asmnoak/All_in_one_DSP_Radio-RDA5807_and_Internet_Radio-xiao_esp32s3/xiao_esp32_i_d_mini_sch_v2.pdf

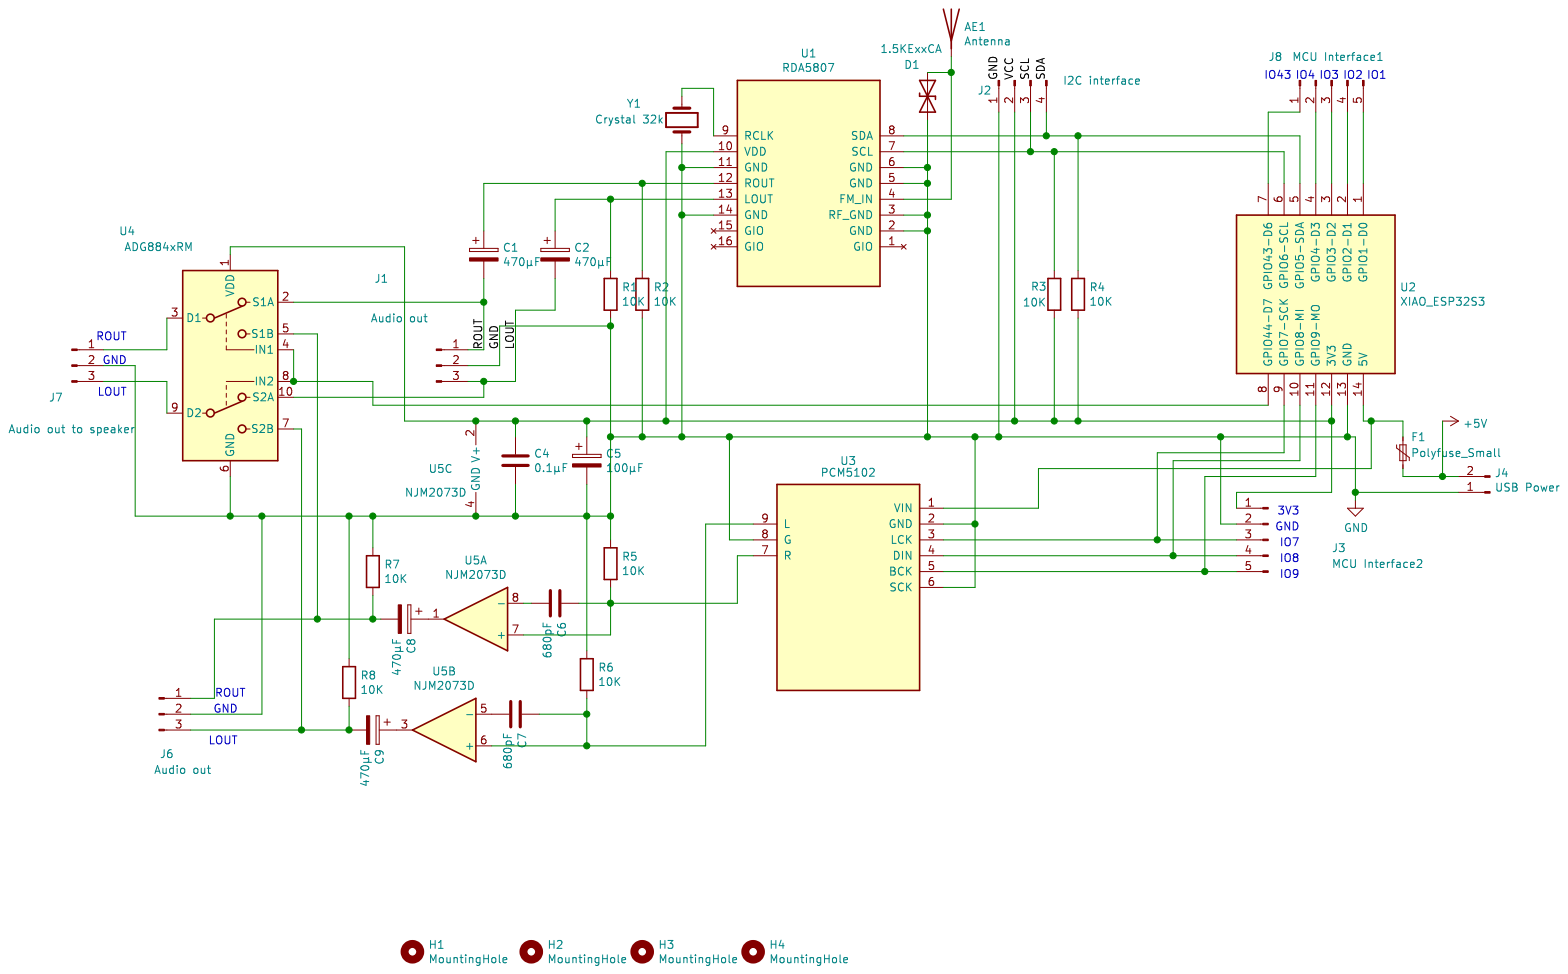
[picture p5: page 1]
