asmnoak/All_in_one_DSP_Radio-RDA5807_and_Internet_Radio-xiao_esp32s3/xiao_esp32s3_ssd1306_i_d_b_radio_master.ino

//**********************************************************************************************************
//*    ESP32S3_inet_and_dsp_radio_srv -- Internet and DSP radio with control function by web server
//*                                      Also you can control ESP32S3 using BLE(Bluetooth LE) GATT without WiFi.
//*
//**********************************************************************************************************
//**********************************************************************************************************
//*    audioI2S -- I2S audiodecoder for ESP32,  refer to https://github.com/schreibfaul1/ESP32-audioI2S                                                            *
//**********************************************************************************************************
//
// Internet radio, first release on 11/2018 for ESP32
//   Version 2  , Aug.05/2019
//   Version 3  , Aug.26/2024 for XIAO ESP32S3
//
// Revise for Internet and DSP : 1/10/2025 - 2/14/2025
// Revise for BLE function     : 3/6/2025 - 4/14/2025
//
#include <BLEDevice.h>
#include <BLEUtils.h>
#include <BLEScan.h>
#include <BLEAdvertisedDevice.h>

#include "Arduino.h"
#include "WiFiMulti.h"
#include "WebServer.h"
#include "Audio.h"
#include <Adafruit_GFX.h>       // install using lib tool
#include <Adafruit_SSD1306.h>   // install using lib tool
#include "Wire.h"
#include <esp_sntp.h>           // esp lib
#include <TimeLib.h>            // https://github.com/PaulStoffregen/Time
#include <Preferences.h>        // For permanent data
#include <RDA5807.h>            // install using lib tool
#define MAXVOL    50          // inet max volume  <= 50
#define MAXVOL_R  15          // radio max volume  <= 15
#define LED_BULTIN       21   // XIAO esp32s3, low level on     
#define I2S_DOUT      8       //## esp32:25  #### old value 2
#define I2S_BCLK      9       //## esp32:26
#define I2S_LRC       7       //## esp32:22
#define SLEEP         43      // sleep timer control button pin #### old value 1 (ver:0.55)
#define PIN_SDA 5             // i2c
#define PIN_SCL 6             // i2c
#define VOL_PIN1     3        // volume up
#define VOL_PIN2     4        // volume down #### old value 44
#define INT_PIN      2        // station change
#define AOUT_SW      44      // audio output switch #### old value 4
#define OLED_I2C_ADDRESS 0x3C // Check the I2C bus of your OLED device
#define SCREEN_WIDTH 128      // OLED display width, in pixels
#define SCREEN_HEIGHT 64      // OLED display height, in pixels
#define OLED_RESET -1         // Reset pin # (or -1 if sharing Arduino reset pin)
#define MAXSTNIDX    7        // station index 0-7          
#define MAXSCEDIDX   8        // schedule table index 0-8
#define VERSION_NR  " ver:0.58"    //
// uuidgen : d392ca55-7a45-47db-adb9-26164b3e7a7b          
static BLEUUID IDBserviceUUID("00001805-7a45-47db-adb9-26164b3e7a7b");
static BLEUUID IDBcharUUID("00002a2b-7a45-47db-adb9-26164b3e7a7b");
static BLEUUID IDBcharDOWUUID("00002a09-7a45-47db-adb9-26164b3e7a7b");
static BLEUUID IDBcharPPCPUUID("00002a04-7a45-47db-adb9-26164b3e7a7b");
#define descriptorUUID "00002901-7a45-47db-adb9-26164b3e7a7b"
#define LOCAL_NAME "DSP_INET_radio"
BLEServer  *pServer = NULL;
BLEClient  *pClient = NULL;
BLEAddress *pBLEAddress = NULL;
BLEDescriptor *pDescriptor = new BLEDescriptor("00002901-7a45-47db-adb9-26164b3e7a7b");  
static bool connected = false;  // ble connection is active 
static bool advertise = false;  // ble advertise is active 
static bool wrote = false;      // ble onwrite() of decriptorcallback
static char strbuff[24];
static const char *stnStr[7] = {"ST0","ST1","ST2","ST3","ST4","ST5","ST6"}; // 3 char, preferences:key of radio station name 
int max_radio = 7;  // max radio station
int bdow = 0; // current browser day of week
int bstn = 0; // current browser radio station
String wstr = "";
//
//
Audio audio;
WiFiMulti wifiMulti;
Adafruit_SSD1306 oled(SCREEN_WIDTH, SCREEN_HEIGHT, &Wire, OLED_RESET);
RDA5807 radio;
// WiFi
String ssid =     "SSID1";         // WiFi 1, specify your access point
String password = "PASSWORD1";
String ssid2 =     "SSID2";      // WiFi 2, uncomment wifiMulti.addAP() below
String password2 = "PASSWORD2";          // if you want to specify it
// time
struct tm *tm;
int d_mon ;
int d_mday ;
int d_hour ;
int d_min = 99;
int d_sec ;
int d_wday ;
int last_d_sec = 99;
int last_d_min = 99;
static const char *weekStr[7] = {"Sun","Mon","Tue","Wed","Thu","Fri","Sat"}; // 3 char, preferences:key of week schedule
int currIdx = 99;
int pofftm_h = 0;
int pofftm_m = 0;
const char* ntpServer = "ntp.nict.jp";
const long  gmtOffset_sec = 32400;
const int   daylightOffset_sec = 0;
// mode: inet or dsp
bool mode_chg_ok = true;
bool mode_chg_req = false;
//
int volume = 2; // inet volume
int station = 0; // inet station url
int ct2,pt2,event;  // interval time 
bool sleepmode = false;
int s_remin = 99;
// mode
int inet_radio = 0;  //0: DSP radio, 1: Internet radio on
bool led_onoff = true;
int loop_cnt = 0;

// Preset internet station url and name
const char* station_url[]={
  "http://cast1.torontocast.com:2170/stream",  "http://cast1.torontocast.com:2120/stream",
  "http://jenny.torontocast.com:8062/stream",  "http://51.195.203.179:8002/stream",
  "http://216.235.89.171:80/hitlist",  "string 6"
};
const char* station_name[]={
  "JPopSakura",  "JPop hits",
  "J1GOLD",  "HotHits UK",
  "POWERHIT40",  "string 6"
}; // max 10 char
char stnurl[128];  // current internet station url
char stnname[24];  // current internet station name
int max_station = 5; // valid entry
// web server
WebServer server(80);  // port 80(default)
// Operation by server
int stoken = 0;  // server token, count up 
int s_srv = 1; // server request 
int s = 1; // toggle sleep
int a_srv = 1;
int b_srv = 1;
char titlebuf[166];
char rstr[128];
// DSP Radio RDA5807
int  vol_r;
//int  lastvol;
int  stnIdx;
int  laststnIdx;
int  stnFreq[] = {8040, 8250, 8520, 9040, 9150, 7620, 7810, 7860}; // frequency of radio station
String  stnName[] = {"AirG", "NW", "NHK", "STV", "HBC", "sanka", "karos", "nosut"}; // name of radio station max 5 char
std::string stnList = "";

String msg = "none";
bool bassOnOff = false;
bool vol_ok = true;
bool stn_ok = true;
bool p_onoff_req = false;
bool p_on = false;
uint32_t currentFrequency;
float lastfreq;
struct elm {  // program
   int stime; // strat time(min)
   int fidx;  // frequency table index
   int duration; // length min
   int volstep; // volume
   int poweroff; // if 1, power off after duration
   int scheduled; // if 1, schedule done for logic
};
struct elm entity[7][MAXSCEDIDX + 1] = {
{{390,1,59,2,1,0},{540,6,59,1,0,0},{600,0,59,1,0,0},{660,3,119,1,0,0},{780,1,59,1,0,0},{840,0,59,1,0,0},{900,6,59,1,0,0},{1140,3,119,1,0,0},{1410,0,29,1,1,0}}, // sun
{{390,4,59,2,1,0},{480,3,119,1,0,0},{600,6,59,1,0,0},{720,2,119,1,0,0},{840,1,119,1,0,0},{0,0,0,0,0,0},{1020,1,119,1,0,0},{1200,6,89,1,0,0},{1410,0,29,1,1,0}}, // mon
{{390,4,59,2,1,0},{480,3,119,1,0,0},{720,2,89,1,0,0},{840,1,119,1,0,0},{0,0,0,0,0,0},{0,0,0,0,0,0},{1020,1,119,1,0,0},{1200,0,89,1,0,0},{1410,0,29,1,1,0}}, // tue
{{390,4,59,2,1,0},{480,3,119,1,0,0},{720,2,89,1,0,0},{840,1,119,1,0,0},{0,0,0,0,0,0},{0,0,0,0,0,0},{1020,1,119,1,0,0},{1200,0,89,1,0,0},{1410,0,29,1,1,0}}, // wed
{{390,4,59,2,1,0},{480,3,119,1,0,0},{600,6,59,1,0,0},{720,2,119,4,0,0},{840,1,119,1,0,0},{960,1,59,1,0,0},{1080,1,119,1,0,0},{1200,0,89,1,0,0},{1290,3,59,1,1,0}}, // thu
{{390,4,59,2,1,0},{480,3,119,1,0,0},{660,0,59,1,0,0},{720,2,119,1,0,0},{840,6,119,1,0,0},{0,0,0,0,0,0},{1080,1,119,1,0,0},{1200,1,89,1,0,0},{1290,3,59,1,1,1}}, // fri
{{390,0,29,2,0,0},{420,2,119,1,0,0},{540,2,110,1,0,0},{720,2,119,1,0,0},{840,2,119,1,0,0},{960,2,119,1,0,0},{1080,4,59,1,0,0},{1140,3,119,1,0,0},{1260,0,89,1,1,0}}  // sat
};
Preferences preferences; // Permanent data "WF0":WiFi SSID, "vol":inet volume, "volr":dsp vol_r , "stix":dsp stnIdx, "stn":inet station
//
//
int setWeeksced(String wstr);
int setStation(String wstr);

class MyDescriptorCallbacks: public BLEDescriptorCallbacks {
  void onWrite(BLEDescriptor *pDesciptor) {
    uint8_t *value = pDescriptor->getValue();
    int vl = pDescriptor->getLength();
    int i;
    wrote = true;
    if (vl >= sizeof(strbuff)) vl = 22;
    Serial.print("***** New value: ");
    memcpy(strbuff, value, vl);
    strbuff[vl] = '\n';
    strbuff[vl+1] = 0;
    if (strbuff[0]=='W') { // Day of Week selection
       bdow = strbuff[2] - '1';
       if (bdow < 0 || bdow >= 7) {
         Serial.println("Description err data");
         bdow=0;
        }
    }
    else if (strbuff[0]=='S') { // Radio Staion selection
       bstn = strbuff[2] - '0';
       if (bstn < 0 || bstn >= MAXSTNIDX) {
         Serial.println("Description err data");
         bstn=0;
        }
    }
    Serial.println(strbuff);
  }
};

class MyCallbacks: public BLECharacteristicCallbacks {
  int typ;
  public:
   MyCallbacks(int t){ typ = t;};
  void onWrite(BLECharacteristic *pCharacteristic) {
    Serial.println("MyCallbacks Write");
    wstr = "";
    msg = "";
    std::string value = pCharacteristic->getValue();
    if (value.length() > 0) {
      Serial.print("***** New value: ");
      for (int i = 0; i < value.length(); i++) {
        Serial.print(value[i]);
        wstr += value[i];
      }
      Serial.println();
      int rc = 0;
      if (value.length() < 40) {
        rc = setStation(wstr);   // register new station
        //if (rc != 0) Serial.println(msg);
      } else {
        rc = setWeeksced(wstr);  // register new schedule
        //if (rc != 0) Serial.println(msg);
      }
      Serial.println(msg);
    }
  }
  void onRead(BLECharacteristic *pCharacteristic) {
    std::string wsced ="";
    char htstr[180];
    Serial.println("MyCallbacks Read");
    if (typ == 0)  return; // nop if not necessary
    int i=bdow;
      wsced = weekStr[bdow];
      wsced += ";";
      for(int j = 0; j <= MAXSCEDIDX; j++) {
        sprintf(htstr,"%d:%02d,%d,%d,%d,%d",entity[i][j].stime / 60,entity[i][j].stime % 60,entity[i][j].fidx,entity[i][j].duration,entity[i][j].volstep,entity[i][j].poweroff);
        wsced += htstr;
        if (j != MAXSCEDIDX) wsced += ";";
      }
      wsced += ";";
    wsced += "\n\0";
    pCharacteristic->setValue(wsced);
  }
};
class MyCallbacks2: public BLECharacteristicCallbacks {
  void onWrite(BLECharacteristic *pCharacteristic) {
    Serial.println("MyCallbacks2 Write");
    wstr = "";
    msg = "";
    std::string value = pCharacteristic->getValue();
    if (value.length() > 0) {
      Serial.print("***** New value: ");
      for (int i = 0; i < value.length(); i++) {
        Serial.print(value[i]);
        wstr += value[i];
      }
      Serial.println();
      if (value.length() < 40) {
        setStation(wstr);   // registor new station
      } else {
        setWeeksced(wstr);  // register new schedule
      }
      Serial.println(msg);
    }
  }
  void onRead(BLECharacteristic *pCharacteristic) {
    std::string stn ="";
    char htstr[80];
    float tf;
    Serial.println("MyCallbacks2 Read");
    int i=bstn;
      stn = stnStr[bstn];
      stn += ",";
      tf = stnFreq[bstn]/100.0;
      sprintf(htstr,"%3.1f",tf);
      stn += htstr;
      stn += ",";
      stn += stnName[bstn].c_str();
    stn += "\n\0";
    pCharacteristic->setValue(stn);
  }
};

class MyServerCallbacks: public BLEServerCallbacks {
  void onConnect(BLEServer* pServer, esp_ble_gatts_cb_param_t *param) {
    pBLEAddress = new BLEAddress(param->connect.remote_bda);
    Serial.printf("MyServerCallbacks Server Connected: %s\n", pBLEAddress->toString().c_str());
    connected = true;
    advertise = false;
    pServer->getAdvertising()->stop();  // stop Advertise
    Serial.println("MyServerCallbacks Stop Advertising");
  }

  void onDisconnect(BLEServer* pServer) {
    Serial.println("MyServerCallbacks Server Disconnected");
    connected = false;
  }
};
int setStation(String val1){
  String instr[12] = {"\n"};
  int ix = split(val1,',',instr);
  if (ix != 3) {
    msg = "different number of arguments.";
    return 4;
  } else {
    //msg = "arguments. ok.";
    instr[0].trim();
    String str = instr[0].substring(2,3);
    int stn = str.toInt();
    char tstr[80];
    sprintf(tstr,"%s:%s==%d", instr[0], str, stn);
    Serial.println(tstr);
    if (stn > MAXSTNIDX-1) { msg = "invalid number of stations."; return 4;}
    else {
      // normal process
      msg = "OK! Processing.";
      if (instr[0].substring(0,1).equals("W")) {// wifi setup
         preferences.putString("WF0", val1);
         Serial.println("Regiter WiFi info: " + val1);
      } else {
        instr[1].trim();
        float freq = instr[1].toFloat();
        if (freq < 50 || freq > 108) {
          msg = "invalid frequency.";
          return 4;
        }
        stnFreq[stn] = freq * 100;
        instr[2].trim();
        stnName[stn] = instr[2];
        preferences.putString(stnStr[stn], val1);  // save permanently
        Serial.println("Regiter new station: " + val1);
      }
      msg = "OK! Done.";
      return 0;
    }
  } 

}


int split(String data, char delimiter, String *dst){
  int index = 0;
  int arraySize = (sizeof(data))/sizeof((data[0]));
  int datalength = data.length();
  
  for(int i = 0; i < datalength; i++){
    char tmp = data.charAt(i);
    if( tmp == delimiter ){
      index++;
      if( index > (arraySize - 1)) return -1;
    }
    else dst[index] += tmp;
  }
  return (index + 1);
}
int dayofWeek(String dow) {
  dow.trim();
  //Serial.println(dow);
  if (dow.equals("Sun")) return 0; 
  else if (dow.equals("Mon")) return 1;
  else if (dow.equals("Tue")) return 2;
  else if (dow.equals("Wed")) return 3;
  else if (dow.equals("Thu")) return 4;
  else if (dow.equals("Fri")) return 5;
  else if (dow.equals("Sat")) return 6;
  else return 9;
}

//Preferences preferences; // Permanent data

int setWeeksced(String val1){
  String instr[12] = {"\n"};
  String instr2[8] = {"\n"};
  String instr3[4] = {"\n"};
  int ix = split(val1,';',instr);
  if (ix != 11) {
    msg = "different number of arguments.";
    return 4;
  } else {
    //msg = "arguments. ok.";
    int down = dayofWeek(instr[0]);
    if (down > 6) { msg = "invalid day of week."; return 4;}
    else {
      // normal process
      msg = "normal process.";
      instr[0].trim();
      Serial.println(instr[0]);
      for(int j = 0; j <= MAXSCEDIDX; j++) {
        instr[j+1].trim();
        msg = "normal process 2.";
        //Serial.println(instr[j+1]);
        String val2 = instr[j+1];
        ix = split(val2,',',instr2);
        if (ix != 5) { 
            msg = "different number of  2nd level arguments.";
            return 4;
        } else {
            //for(int i = 0; i < 5; i++) {
              msg = "OK! Processing.";
              //Serial.println(instr2[i]);
              val2 = instr2[0];
              ix = split(val2,':',instr3);
              if (ix != 2) {
                msg = "different number of  3rd level arguments.";
                return 4;
              }
              instr3[0].trim();
              instr3[1].trim();
              entity[down][j].stime = instr3[0].toInt() * 60 + instr3[1].toInt();
              instr3[0] = "";
              instr3[1] = "";
              instr2[0] = "";

              entity[down][j].fidx = instr2[1].toInt();
              // todo: check fidx
              instr2[1] = "";
              entity[down][j].duration = instr2[2].toInt();
              instr2[2] = "";
              entity[down][j].volstep = instr2[3].toInt();
              instr2[3] = "";
              entity[down][j].poweroff = instr2[4].toInt();
              instr2[4] = "";
              entity[down][j].scheduled = 0; // reset
              preferences.putString(weekStr[down], val1);  // save permanently
            //}
        }
        
      }
      if (d_wday==down) { //  Is schedule of today changed?  (ver:0.52)
        pofftm_h = 0;     // clear power off time
        pofftm_m = 0;
        Serial.println("reset power off time");
      }
      msg = "OK! Done.";
      return 0;
    }
  } 
}
void handleRoot(void)
{
  String html;
  String val1;
  String val2;
  String val3;
  String val4;
  String val5;
  String val6;
  String val7;
  String val8;
  String val9;
  String val10;
  String val11;
  String html_btn0 = "<p><div class=\"lay_i\"><input type=\"submit\" name=\"dsp\"  value=\"dsp_radio\" class=\"btn_g\"><input type=\"submit\" name=\"inet\" value=\"inet_radio\" class=\"btn\"></div></p>";
  String html_btn1 = "<p><div class=\"lay_i\"><input type=\"submit\" name=\"dsp\"  value=\"dsp_radio\" class=\"btn\"><input type=\"submit\" name=\"inet\" value=\"inet_radio\" class=\"btn_g\"></div></p>";
  String html_p1; 
  char htstr[180];
  char stnno[4];    
  char tno[4];
  char stnmsg[12];
  bool responsed = false;
  stnmsg[0]=0;

  Serial.println("web received");
  if (inet_radio == 0) html_p1 = html_btn0; else html_p1 = html_btn1;
  if (server.method() == HTTP_POST) { // submitted with string
    val1 = server.arg("daysced");
    val2 = server.arg("vup");
    val3 = server.arg("vdown");
    val4 = server.arg("stnup");
    val5 = server.arg("stndown");
    val6 = server.arg("sleep");
    val7 = server.arg("stoken");
    val8 = server.arg("stnset");
    val9 = server.arg("pwonoff");
    val10 = server.arg("dsp");
    val11 = server.arg("inet");
    if (val7.length() != 0) { // server token
      Serial.print("stoken:");
      String s_stoken = server.arg("stoken");
      int t_stoken = s_stoken.toInt();
      Serial.println(s_stoken);
      msg = "stoken:" + s_stoken;
      if (stoken > t_stoken) {
        Serial.println("redirect");
        msg = "Post converted to Get";
        responsed = true;
        server.send(307, "text/html", "<!DOCTYPE html><html><head><meta charset=\"utf-8\"><meta http-equiv=\"refresh\" content=\"0;url=/\"></head></html>");
      }
    }
    if (!responsed){
      ////
      if (val10.length() != 0) {
        Serial.println("dsp");
        if (mode_chg_ok && (inet_radio == 1)) {
          // inet --> dsp
          html_p1 = html_btn0;
          mode_chg_ok = false;
          mode_chg_req = true;
        }
        msg = "dsp";
      }
      else if (val11.length() != 0) {
        Serial.println("inet");
        if (mode_chg_ok && (inet_radio == 0)) {
          // dsp --> inet
          html_p1 = html_btn1;
          mode_chg_ok = false;
          mode_chg_req = true;
        }
        /*WiFiClient client = server.client(); 
        client.println("HTTP/1.1 307 Temporary Redirect");
        client.println("Location: /ir");
        client.println("Connection: Close");
        client.print("<HEAD>");
        client.print("<meta http-equiv=\"refresh\" content=\"0;url=/ir\">");
        client.print("</head>");
        client.println();
        client.stop();*/
        msg = "inet";
      } else if (val8.length() != 0) {
        Serial.println("station set");
        if (val8 == "set") {
          Serial.print("Set_staion: ");
          // Get input station setting
          String s_stnurl = server.arg("stnurl");
          String s_stnname = server.arg("stnname");
          String s_stnno = server.arg("stnno");
          Serial.print(s_stnno); Serial.print(" "); Serial.print(s_stnname); Serial.print(" ");
          Serial.println(s_stnurl);
          // Set current
          strcpy(stnurl,s_stnurl.c_str());
          strcpy(stnname,s_stnname.c_str());
          station = s_stnno.toInt() - 1;
          if (station < max_station && station >= 0) {
            bool conn_ok;
            conn_ok=audio.connecttohost(s_stnurl.c_str()); // change station
            if (conn_ok) {
                Serial.println("Set new staion OK");
                msg = "Set new staion OK";
            } else {
                Serial.println("Set new staion failed");
                strcpy(stnmsg,"Err!");
                msg = "Set new staion error";
            }
          } else msg = "illegal station number";
        } else if (val8 == "save") {
          String s_stnurl = server.arg("stnurl");
          String s_stnname = server.arg("stnname");
          String s_stnno = server.arg("stnno");
          int stnno = s_stnno.toInt();
          Serial.print(s_stnno); Serial.print(" "); Serial.print(s_stnname); Serial.print(" ");
          Serial.println(s_stnurl);
          if (stnno - 1 <= max_station && stnno -1 >= 0) {
            char tstr[166];
            sprintf(tstr,"%s%d","st", stnno);
            preferences.putString(tstr,s_stnurl);
            sprintf(tstr,"%s%d","nm", stnno);
            preferences.putString(tstr,s_stnname);
            msg = "new station saved";
          } else msg = "illegal station number";
        }
        else msg = "ignore it";
      }
      else if (val2.length() != 0) {
        Serial.println("vup");
        b_srv=0; 
        msg = "control vup";
      }
      else if (val3.length() != 0) {
        Serial.println("vdown");
        a_srv=0; 
        msg = "control vdown";
      }
      else if (val4.length() != 0) {
        Serial.println("stnup");
        station_setting();
        msg = "control stnup";
      }
      else if (val5.length() != 0) {
        Serial.println("stndown");
        station_setting();
        msg = "control stndown";
      }
      else if (val6.length() != 0) {
        Serial.println("sleep");
        sleep_setting();
        msg = "control sleep";
      }
      else if (val9.length() != 0) {
        Serial.println("pwonoff");
        if (inet_radio==0 || inet_radio==1) { // dsp radio, or inet (changed)
          power_onoff_setting(); 
          msg = "control pwonoff";
        } else msg = "ignore it";
      }
      else if (val1.length() != 0) {
        Serial.println("daysched");
        if (inet_radio>=0) { // dsp radio or inet radio
          int rc = setWeeksced(val1); 
          //msg = "control daysched";
        } else msg = "ignore it";
      }
      else {
        // nop        
      } 
    }
  } 
  if (!responsed) {
    html = "<!DOCTYPE html><html><head><meta charset=\"utf-8\"><title>DSP Inet Radio</title>";
    html +="</head><body><form action=\"\" method=\"post\">";
    html += "<p><h2>DSP Radio & Internet Radio</h2></p>";
    html += html_p1;
    html += "<style>.lay_i input:first-of-type{margin-right: 20px;}</style>";
    html += "<style>.btn {width: 300px; padding: 10px; box-sizing: border-box; border: 1px solid #68779a; background: #cbe8fa; cursor: pointer;}</style>";
    html += "<style>.btn_y {width: 300px; padding: 10px; box-sizing: border-box; border: 1px solid #68779a; background: #ffff8a; cursor: pointer;}</style>";
    html += "<style>.btn_g {width: 300px; padding: 10px; box-sizing: border-box; border: 1px solid #68779a; background: #99ff99; cursor: pointer;}</style>";
    //html += "<script>function stokenupd() {const hdtoken = document.getElementById('stoken'); hdtoken.value += 1;}</script>";
    html += "<p>Control Functions</p>";
    html += "<p><div class=\"lay_i\"><input type=\"submit\" name=\"vup\"  value=\"volume up\" class=\"btn\"><input type=\"submit\" name=\"vdown\" value=\"volume down\" class=\"btn\"></div></p>";
    html += "<p><div class=\"lay_i\"><input type=\"submit\" name=\"stnup\"  value=\"station change\" class=\"btn\"></div></p>";
    html += "<p><div class=\"lay_i\"><input type=\"submit\" name=\"pwonoff\"  value=\"dsp_radio pwr_on_off\" class=\"btn_y\">";
    html += "<input type=\"submit\" name=\"sleep\"  value=\"inet_radio sleep\" class=\"btn_y\"></div></p>";
    html += "<p>Volume: ";
    if (inet_radio==1) sprintf(tno,"%d",volume); else sprintf(tno,"%d",vol_r);
    html += tno;
    html += "</p>";
    html += "<p>Response: " + msg + "</p>";
    html += "<p><h3>Internet Radio Info</h3></p>";
    html_p1 = String(stnname);
    html += "<p>Now playing: " + html_p1 + " (" + stnurl +  ") "  + "</p>";
    html_p1 = String(titlebuf);
    html += "<p>" + html_p1 + "</p>";
    html += "<p>Station List: </p>";
    html += "<p><ol>";
    for (int j=0; j < max_station; j++) {
      html += "<li>";
      sprintf(htstr, "%.10s%s%s", station_name[j],  " - ",  station_url[j]);
      html +=  htstr;
      html += "</li>";
    }
    html += "</ol></p>";
    html += "<p></p><p>Preference Settings</p>";
    html += "<table style=\”border:none;\”><tr>";
    html += "<td>Station URL:</td>";
    if (strlen(stnmsg)==0) {
      html += "<td></td>";
    } else {
      html += "<td><font color=\"#ff4500\">Err!</font></td>";
    }
    html += "<td><input type=\"text\" name=\"stnno\" size=\"3\" maxlength=\"2\" value=\"";
    html += station + 1;
    html += "\"></td><td>";
    html += "<td><input type=\"text\" name=\"stnname\" size=\"18\" maxlength=\"23\" value=\"";
    html += stnname;
    html += "\"></td><td>";
    html += "<input type=\"text\" name=\"stnurl\" size=\"64\" maxlength=\"127\" value=\"";
    html += stnurl;
    html += "\">";
    html += "<button type=\"submit\" name=\"stnset\" value=\"set\">TEST SET</button>";
    html += "<button type=\"submit\" name=\"stnset\" value=\"save\">SAVE</button>";
    html += "</td></tr></table>";
    html += "<input type=\"hidden\" name=\"stoken\" value=\"";
    stoken += 1;
    html += stoken;
    html += "\">"; 
    //
    html += "<p><h3>Schedule Setting</h3></p>";
    html += "<p>Select a day of the week, change it, then submit.</p>";
    html += "<p>";
    html += "<input type=\"text\" id=\"daysced\" name=\"daysced\" size=\"120\" value=\"\">";
    html += "</p><p><input type=\"submit\" value=\"submit\" class=\"btn\"></p></form>";
    html += "<p>Response: " + msg + "</p>";
    html += "<p>Arguments of enrty: Start time(hour:min),Station(See below),Duration(min),Volume,Pweroff</p>";
    html += "<p>Station List: 0=" + stnName[0] + ",1=" + stnName[1] + ",2=" + stnName[2] + ",3=" + stnName[3] + ",4=" + stnName[4];
    html += ",5=" + stnName[5] + ",6=" + stnName[6] +  ",7=" + stnName[7] + ",above 50 = inet_radio</p>";
    html += "<script>";
//    html += "let entity = [[[390,1,59,4,1],[540,6,59,2,0],[600,0,59,2,0],[660,3,119,2,0],[780,1,59,2,0],[840,0,59,2,0],[900,1,59,2,0],[1140,3,119,2,0],[1410,0,29,2,1]],";
//    html += "[[390,1,59,4,1],[540,6,59,2,0],[600,0,59,2,0],[660,3,119,2,0],[780,1,59,2,0],[840,0,59,2,0],[900,1,59,2,0],[1140,3,119,2,0],[1410,0,29,2,1]]]";
    html += "let entity = [";
    for (int i = 0; i < 7; i++){
      html += "[";
      for(int j = 0; j <= MAXSCEDIDX; j++) {
        sprintf(htstr,"['%d:%02d',%d,%d,%d,%d]",entity[i][j].stime / 60,entity[i][j].stime % 60,entity[i][j].fidx,entity[i][j].duration,entity[i][j].volstep,entity[i][j].poweroff);
        html += htstr;
        if (j != MAXSCEDIDX) html += ",";
      }
      html += "]";
      if (i != 6) html += ",";
    }
    html += "];";
    html += "let week = [\"Sun\",\"Mon\",\"Tue\",\"Wed\",\"Thu\",\"Fri\",\"Sat\"];";
    html += "document.write('<table id=\"tbl\" border=\"1\" style=\"border-collapse: collapse\">');";
    html += "for (let i = 0; i < 7; i++){";
    html += "let wstr ='';";
    html += "wstr ='<tr>' + '<td>' + '<input type=\"radio\" name=\"week\" value=\"\" onclick=\"setinput(' + i + ')\">' + '</td>' + '<td>' + week[i] + '</td>';";
    html += "document.write(wstr);";
    html += "for (let j = 0; j < 9; j++){";
    html += "document.write('<td>');";
    html += "document.write(entity[i][j]);";
    html += "document.write('</td>');}";
    html += "document.write('</tr>');";
    html += "}";
    html += "document.write('</table>');";
    html += "function setinput(trnum) {";
    html += "var input = document.getElementById(\"daysced\");";
    html += "var table = document.getElementById(\"tbl\");";
    html += "var cells = table.rows[trnum].cells;";
    html += "let istr = '';";
    html += "for (let j = 1; j <= 10; j++){";
    html += "istr = istr + cells[j].innerText + ';';";
    html += "}";
    html += "input.value = istr;";
    html += "}";
    html += "</script>";
    //
    html += "</form></p></body>";
    html += "</html>";
    server.send(200, "text/html", html);
    Serial.println("web send response");
  }
//}
}

void handleNotFound(void)
{
  server.send(404, "text/plain", "Not Found.");
}

void setup()
{
  bool ble = false;
  struct tm tm_init;
  struct timeval tv = { 1710000000 + gmtOffset_sec , 0 };  // initial value is 2024/3/9 16:00 + 9:00
  pinMode(LED_BUILTIN, OUTPUT);
  digitalWrite(LED_BUILTIN, HIGH);
  pinMode(AOUT_SW, OUTPUT);
  digitalWrite(AOUT_SW, HIGH);
  Serial.begin(115200);
  delay(50);
    pinMode(VOL_PIN1, INPUT_PULLUP);
    pinMode(VOL_PIN2, INPUT_PULLUP);
    pinMode(INT_PIN, INPUT_PULLUP);
    pinMode(SLEEP, INPUT_PULLUP); // sleep after about 60 min when button was pressed
    //
    attachInterrupt(INT_PIN,station_setting, FALLING); // to change station
    attachInterrupt(VOL_PIN1,volup_setting, FALLING); // to change volue up
    attachInterrupt(VOL_PIN2,voldown_setting, FALLING); // to change volume down
    attachInterrupt(SLEEP,sleep_setting, FALLING); // to change sleep on/off
  Wire.setPins(PIN_SDA, PIN_SCL);  
  Wire.begin(); //
    oled.begin(SSD1306_SWITCHCAPVCC, OLED_I2C_ADDRESS);
    oled.clearDisplay();
    oled.setTextColor(SSD1306_WHITE);
  // restore saved settings
    preferences.begin("inet_p", false);
    //preferences.clear(); // for debug
    String wfval = preferences.getString("WF0","");
    if (wfval != "") { // WiFi info
      String instr[4] = {"\n"};
      int ix = split(wfval,',',instr);
      instr[1].trim();
      instr[2].trim();
      ssid = instr[1];
      Serial.print("WiFi ssid : "); Serial.println(ssid);
      password = instr[2];
    }
    for (int i = 0; i < MAXSTNIDX; i++){
       String val1 = preferences.getString(stnStr[i],"");       
       stnList += val1.c_str();
       stnList += ";";   
       if (val1 != "") {
         Serial.println(val1);
         int rc = setStation(val1);
         if (rc != 0) Serial.println(msg);
       }
    }
    for (int i = 0; i < 7; i++){
       String val1 = preferences.getString(weekStr[i],"");       
       if (val1 != "") {
         //Serial.println(val1);
         int rc = setWeeksced(val1);
       }
    }
    for (int i = 0; i < max_station; i++){
       char tstr[166];
       String *tcp;
       sprintf(tstr,"%s%d","st",i+1);
       String val1 = preferences.getString(tstr,"");       
       if (val1 != "") {
         tcp = new String(val1.c_str());
         Serial.print(tcp->c_str()); Serial.print(",");        
         station_url[i] = tcp->c_str();
         sprintf(tstr,"%s%d","nm",i+1);
         val1 = preferences.getString(tstr,"");
         tcp = new String(val1.c_str());
         Serial.println(tcp->c_str());
         station_name[i] = tcp->c_str();
       }
    }
    volume = preferences.getInt("vol", -1);
    if (volume < 0) volume = 3;
    vol_r = preferences.getInt("volr", -1);
    if (vol_r < 0)  vol_r = 2;
    //lastvol = vol_r;
    //
    stnIdx = preferences.getInt("stix", -1);
    if (stnIdx < 0)  stnIdx = 3;
    lastfreq = stnFreq[stnIdx];
    laststnIdx = stnIdx;
    //
    station = preferences.getInt("stn", -1);
    if (station < 0) station = 0;
    //
  event = 0;
  pt2=millis();
    oled.setTextSize(2); // Draw 2X-scale text
    oled.setCursor(0, 0);
    oled.print("Inet Radio");
    oled.setCursor(0, 15);
    oled.print(VERSION_NR);
    oled.display();
    WiFi.mode(WIFI_STA);
    wifiMulti.addAP(ssid.c_str(), password.c_str());  
    //wifiMulti.addAP(ssid2.c_str(), password2.c_str());  // uncomment if you want second wifi access point
    wifiMulti.run();   // It may be connected to strong one
    delay(1000);  // Wait for Wifi ready
    while (!ble) {
      if(WiFi.status() == WL_CONNECTED){ break; }  // WiFi connect OK then next step
      Serial.println("WiFi Err");
      oled.setCursor(0, 30);
      oled.print("WiFi Err");
      oled.display();
      for (int l = 0; l < 200; l++) {
        if (s == 0) { // sleep sw push ?
          settimeofday(&tv, NULL); // Set temp time
          s = 1; // reset
          ble = bleservice();
          if (ble) { // service is initialized
            oled.setCursor(0, 45);
            oled.print("BLE mode");
            oled.display();
            delay(2000);
            break;
          } else {
            oled.setCursor(0, 45);
            oled.print("BLE ERR");
            oled.display();
            delay(2000);
          } 
        }
        else delay(1000); // 200 * 1000         
      }
      if (!ble) {
        WiFi.disconnect(true);
        delay(3000);
        wifiMulti.run();
        delay(1000);  // Wait for Wifi ready
      } else break;      
    }
  oled.setCursor(0, 30);
  oled.print("WiFi OK");
  oled.display();
  // time 
  if (!ble) {
    wifisyncjst(); // refer time and day
    //
    int ownrst_ind = preferences.getInt("ownrst",-1);
    if (ownrst_ind==99) { // own restart
      // current time
      time_t t = time(NULL);
      tm = localtime(&t);
      d_mon  = tm->tm_mon+1;
      d_mday = tm->tm_mday;
      d_hour = tm->tm_hour;
      d_min  = tm->tm_min;
      d_sec  = tm->tm_sec;
      d_wday = tm->tm_wday;
      // check schedule
      for(int i = 0; i <= MAXSCEDIDX; i++) {
         if ((entity[d_wday][i].stime <= d_hour * 60 + d_min) && 
              ((entity[d_wday][i].stime + entity[d_wday][i].duration) >= (d_hour * 60 + d_min ))
            ) {
                  entity[d_wday][i].scheduled = 1;
              }
      }
      preferences.putInt("ownrst", 0); // reset own restart
    }
  }
  radio.setup(); // Stats the receiver with default valuses. Normal operation
  delay(100);
  radio.setBand(2); //
  radio.setSpace(0); //
  radio.setVolume(vol_r);
  radio.setFrequency(stnFreq[stnIdx]);  // 
  delay(100);
  p_on = true;
  if (!ble) {
    audio.setPinout(I2S_BCLK, I2S_LRC, I2S_DOUT);
    audio.setVolume(volume); 
    strcpy(stnurl,station_url[station]); // use preset
    strcpy(stnname,station_name[station]);
    bool conn_ok = false;
    WiFi.setTxPower(WIFI_POWER_17dBm); // TX power strong   #### xiao < 17dbm
    Serial.println("TX power 17dBm");
    server.on("/", handleRoot);
    server.onNotFound(handleNotFound);
    server.begin();
    Serial.print("IP = ");
    Serial.println(WiFi.localIP());
    IPAddress ipadr = WiFi.localIP();
      oled.setCursor(0, 45);
      oled.printf("IP:%d.%d", ipadr[2],ipadr[3]);
      oled.display();
  }
    titlebuf[0] = 0;
    //WiFi.setTxPower(WIFI_POWER_17dBm); // TX power 
    digitalWrite(LED_BUILTIN, LOW); // led on
    delay(2000); // time to see ipaddress

}
void wifisyncjst() {
  // get jst from NTP server
  int lcnt = 0;
  configTzTime("JST-9", "ntp.nict.jp", "ntp.jst.mfeed.ad.jp");
  delay(500);
  // get sync time
  while (sntp_get_sync_status() == SNTP_SYNC_STATUS_RESET) {
    delay(500);
    lcnt++;
    if (lcnt > 100) {
      Serial.println("time not sync within 50 sec");
      break;
    }
  }
}

bool bleservice()
{
  Serial.println("\nBLEServer");

  //settimeofday(&tv, NULL); // Set temp time

  BLEDevice::init(LOCAL_NAME);
  BLEDevice::setEncryptionLevel(ESP_BLE_SEC_ENCRYPT);  //

  pServer = BLEDevice::createServer();
  pServer->setCallbacks(new MyServerCallbacks());
  // Service and Characteristic
  BLEService *pService = pServer->createService(IDBserviceUUID);
  BLECharacteristic *pCharacteristic = pService->createCharacteristic(
   IDBcharUUID,
   BLECharacteristic::PROPERTY_READ |
   BLECharacteristic::PROPERTY_WRITE
  );
  pCharacteristic->setCallbacks(new MyCallbacks(0));
  pCharacteristic->setValue(stnList);  // Radio Staions List
  // Descriptor
  pDescriptor->setValue("1710032400");
  pDescriptor->setCallbacks(new MyDescriptorCallbacks());
  pCharacteristic->addDescriptor(pDescriptor);
  // DOW Char
  BLECharacteristic *pCharacteristic2 = pService->createCharacteristic(
   IDBcharDOWUUID,
   BLECharacteristic::PROPERTY_READ |
   BLECharacteristic::PROPERTY_WRITE
  );
  pCharacteristic2->setCallbacks(new MyCallbacks(1));
  // PPCP Char
  BLECharacteristic *pCharacteristic3 = pService->createCharacteristic(
   IDBcharPPCPUUID,
   BLECharacteristic::PROPERTY_READ |
   BLECharacteristic::PROPERTY_WRITE
  );
  pCharacteristic3->setCallbacks(new MyCallbacks2());

  String wsced = "";
  char htstr[180];
  char sstr[480];
  sstr[0] = 'g';
  sstr[1] = 's';
  sstr[2] = 0;
  std::string cstr;
  Serial.println("Set Char for Read");
  int i=bdow;
  wsced = weekStr[bdow];
  wsced += ";";
  for(int j = 0; j <= MAXSCEDIDX; j++) {
    sprintf(htstr,"%d:%02d,%d,%d,%d,%d",entity[i][j].stime / 60,entity[i][j].stime % 60,entity[i][j].fidx,entity[i][j].duration,entity[i][j].volstep,entity[i][j].poweroff);
    wsced += htstr;
    if (j != MAXSCEDIDX) wsced += ";";
  }
  wsced += ";";
  wsced += "\n\0";
  Serial.println(wsced);
  //  pCharacteristic->setValue(wsced);
  cstr = wsced.c_str();
  pCharacteristic2->setValue(cstr);
  pCharacteristic3->setValue("ST1,80.4,AirG"); // Radio Staion Parameter
  // start service 
  pService->start();
  return true;
}

void loop()
{
  char ts[80];
  char slp[8];
  float tf;
  if (connected) { // ble connected now?
    delay(300);
    digitalWrite(LED_BUILTIN, LOW);   // turn pilot LED on 
    delay(300);                        // wait for a while
    digitalWrite(LED_BUILTIN, HIGH);    // turn pilot LED off 
  }
  if (!connected && !advertise) {  // ble connection is not active
    advertise = true;
    pServer->getAdvertising()->start();
    Serial.println("Start Advertising");
  }
  if (wrote) { // If there is a ble signal, run it.
    wrote = false;
    if ((strbuff[0] - '0' >= 0) && (strbuff[0] - '9' <= 9)) { // Unix time(sec) ?
      long t_sec = 0;
      String *tstr = new String(strbuff);
      t_sec = tstr->toInt();
      struct timeval tv = { t_sec + gmtOffset_sec, 0 };  // set current time
      settimeofday(&tv, NULL);
    } else { // command input
      if (strbuff[0]=='v') {  // v+ or v- : volume
        if (strbuff[1]=='+') { // on
          volup_setting(); // v+
        } else { // other off
          voldown_setting();  // maybe v-
        }  
      } else if (strbuff[0]=='s') { // s+ or s- : station select
        if (strbuff[1]=='+') { // on
          station_setting(); // s+
        } else { // other off
          station_setting_2(); // maybe s-
        }  
      } else if (strbuff[0]=='o') {
          power_onoff_setting(); // on or off req 
      }
    }
  }
  // if wifi is ok, check web server req
  if (WiFi.status() == WL_CONNECTED) server.handleClient();
  //
  if (mode_chg_req) { // mode change request
    if (inet_radio==0) { // dsp -> inet
      strcpy(stnurl,station_url[station]); // use preset
      strcpy(stnname,station_name[station]);
      bool conn_ok = false;
      WiFi.setTxPower(WIFI_POWER_17dBm); // TX power strong   #### xiao < 17dbm
      Serial.println("TX power 17dBm");
      conn_ok = audio.connecttohost(stnurl); 
      if (!conn_ok) { // conect failure
        Serial.println("Fail to connect");
      } else { // connect ok
        
        inet_radio = 1;  //1: Internet radio
        digitalWrite(AOUT_SW, LOW);
        radio.powerDown();
        audio.setVolume(volume); 
        p_on = true;
      }
      mode_chg_ok = true;
      mode_chg_req = false;
    } else { // inet -> dsp
      audio.stopSong(); // inet stop, then set dsp_radio on
      server.stop();
      // disconnect WiFi to restart 
      WiFi.disconnect(true);
      //Serial.println("WiFi Reconnect");
      oled.setTextSize(2); // Draw 2X-scale text
      oled.clearDisplay();
      oled.setCursor(0, 0);
      //oled.print("WiFi Recon");
      oled.print("Restart");
      oled.display();
      Serial.println("Restart");
      //Serial.println("WiFi Reconnect");
      delay(1500);
      // restart  system
      preferences.putInt("ownrst",99);
      ESP.restart();
      // 
      wifiMulti.run();
      delay(1000);
      while (true) {
        if(WiFi.status() == WL_CONNECTED){ break; }  // WiFi connect OK then next step
        Serial.println("WiFi Err");
        oled.setCursor(0, 30);
        oled.print("WiFi Err");
        oled.display();
        WiFi.disconnect(true);
        delay(1000*300);  // Wait for Wifi ready
      }
      server.on("/", handleRoot);
      server.onNotFound(handleNotFound);
      server.begin();
      //  
      digitalWrite(LED_BUILTIN, LOW);     // led on  
      p_onoff_req = true;
      inet_radio = 0;  //0: DSP radio
      p_on = false;
      mode_chg_ok = true;
      mode_chg_req = false;
    }
  }
  
  if (inet_radio==1 || inet_radio==0) { // process server request
    if (a_srv==0 || b_srv==0) { // by server operation
      Serial.println("Server vol change");
      updatevolume(a_srv, b_srv);
      a_srv=1;
      b_srv=1;
    }
    if (s==0 || s_srv==0) { // button or by server operation
      sleepmode = !sleepmode;
      if (sleepmode) {
        Serial.println("Sleep timer ON");
        s_remin = 60;
      } else {
        Serial.println("Sleep timer OFF");
        s_remin = 60;
      }
      s=1;
      s_srv=1;
    }
  }
  if (inet_radio==1) {
    loop_cnt ++;
    if (loop_cnt > 500) { // about 3 sec in normal process
      loop_cnt = 0;
      led_onoff = !led_onoff;
      if (led_onoff) {
        digitalWrite(LED_BUILTIN, LOW); // on
        oled_display(1); // inet info
      }
      else {
        digitalWrite(LED_BUILTIN, HIGH); // off
        oled_display(0); // time
      }
    }
    audio.loop(); // Inter net radio function call
  }
  if ((event==1) && (inet_radio==1)) { // interrupt of change station request ?
      char tstr[166];
      event = 0; // clear 
      strcpy(stnurl,station_url[station]); 
      strcpy(stnname,station_name[station]);
      audio.connecttohost(station_url[station]); // change station.
      // save change
      sprintf(tstr,"%s%d","st", station + 1);
      preferences.putString(tstr,stnurl);
      sprintf(tstr,"%s%d","nm", station + 1);
      preferences.putString(tstr,stnname);
      preferences.putInt("stn",station);
  }
  // power off process
  if (inet_radio==1) {
    if (p_onoff_req) {
      if (p_on) {
        audio.stopSong();
        Serial.println("inet pw off");
        p_on = false;
      } else {
        Serial.println("inet pw on");
        audio.connecttohost(station_url[station]); 
        delay(100);
        digitalWrite(AOUT_SW, LOW);
        p_on = true;
      }
      p_onoff_req = false;
    }
  }
  if (inet_radio==0) {
    if (p_onoff_req) {
      if (p_on) {
        radio.powerDown();
        Serial.println("radio pw off");
        p_on = false;
      } else {
        radio.powerUp();
        delay(100);
        stnIdx = preferences.getInt("stix", -1);
        if (stnIdx==-1) stnIdx = 3;
        radio.setFrequency(stnFreq[stnIdx]);
        radio.setVolume(vol_r);
        delay(50);
        lastfreq = stnFreq[stnIdx];
        laststnIdx = stnIdx;
        Serial.println("radio pw on");
        digitalWrite(AOUT_SW, HIGH);
        p_on = true;
      }
      p_onoff_req = false;
    }
    if (laststnIdx != stnIdx) {
      stn_ok = true;  //  moved, ver 0.58
      preferences.putInt("stix", stnIdx);  //  moved, ver 0.58
      Serial.print("stn changed:");
      Serial.println(stnIdx);
      radio.setFrequency(stnFreq[stnIdx]);
      lastfreq = stnFreq[stnIdx];
      laststnIdx = stnIdx;
    }
    oled.clearDisplay();
    oled.setTextSize(2); // Draw 2X-scale text
    // display current time
    time_t t = time(NULL);
    tm = localtime(&t);
    d_mon  = tm->tm_mon+1;
    d_mday = tm->tm_mday;
    d_hour = tm->tm_hour;
    d_min  = tm->tm_min;
    d_sec  = tm->tm_sec;
    d_wday = tm->tm_wday;
    //Serial.print("time ");
    if (last_d_sec != d_sec) {
      sprintf(ts,"%02d:%02d:%02d",d_hour,d_min,d_sec);
      //Serial.println(ts);
      oled.setTextSize(2); // Draw 2X-scale text
      oled.clearDisplay();
      oled.setCursor(0, 0);
      oled.print(ts);
      //Serial.println(ts);
      if (sleepmode) sprintf(slp,"%s","SLP:"); else sprintf(slp,"%s","Vol:");
      sprintf(ts, "%02d-%02d %s", d_mon, d_mday, weekStr[d_wday]);
      //sprintf(ts, "RSSI:%03d", radio.getRssi());
      oled.setCursor(0, 15);
      oled.print(ts);
      int pi = p_on ? 1 : 0; // power indicator
      if (sleepmode) 
        sprintf(ts, "%.4s%02d %s%01d", slp, s_remin, "P:", pi);
      else
        sprintf(ts, "%.4s%02d %s%01d", slp, vol_r, "P:", pi);
      oled.setCursor(0, 30);
      oled.print(ts);
      tf = lastfreq/100.0;
      sprintf(ts, "%3.1f S:%03d", tf, radio.getRssi()); // frequency and signal strength
      oled.setCursor(0, 45);
      oled.print(ts);
      oled.display();
      if (sleepmode) check_sleep();
      last_d_sec = d_sec; // 
      delay(300); // if inet radio off , delay ok here
    }
  }
  // Check Schedule 
  if (last_d_min != d_min) {
    last_d_min = d_min;
    if (pofftm_h == d_hour && pofftm_m == d_min && p_on) { // power off time ?
      p_onoff_req = true;
      pofftm_h = 0;
      pofftm_m = 0;
    } else {
      for(int i = 0; i <= MAXSCEDIDX; i++) {
        if ((entity[d_wday][i].stime == 0) && !((i == 0) && (entity[d_wday][i].duration > 0))) {     
          //nop
          //Serial.println(d_min);
        } else {
          //Serial.println(entity[d_wday][i].stime);
          if ((entity[d_wday][i].stime <= d_hour * 60 + d_min) && 
              ((entity[d_wday][i].stime + entity[d_wday][i].duration) >= (d_hour * 60 + d_min ))
              && (entity[d_wday][i].scheduled != 1)) {
            if (lastfreq == stnFreq[entity[d_wday][i].fidx] && entity[d_wday][i].fidx < 50 && inet_radio==0) {
              //entity[d_wday][i].scheduled = 1; // mark it scheduled
            } else {          
              //radio.setFrequency(stnFreq[entity[d_wday][i].fidx]);
              stnIdx =  entity[d_wday][i].fidx;
              if (stnIdx >= 50) {
                int  lstation = station;
                station = stnIdx - 51; // 51->0, 52->1, and so on (ver 0.54)
                if (station > max_station || station < 0) station = 0; // (ver 0.54)
                strcpy(stnurl,station_url[station]); 
                strcpy(stnname,station_name[station]);
                if (inet_radio==0) mode_chg_req = true;
                if (inet_radio==1 && station != lstation) event = 1;       // change station
                volume = entity[d_wday][i].volstep; // inet
                preferences.putInt("stn", station);
                preferences.putInt("vol", volume);
              } else {
                if (inet_radio==1) mode_chg_req = true;
                vol_r = entity[d_wday][i].volstep;    // dsp
                preferences.putInt("stix", stnIdx);
                preferences.putInt("volr", vol_r);
              }
            }                     
            
            currIdx = i;
            entity[d_wday][i].scheduled = 1; // mark it scheduled
            Serial.println("scheduled");
            if (entity[d_wday][i].poweroff==1) { // power off ?
              pofftm_h = (entity[d_wday][i].stime + entity[d_wday][i].duration) / 60; // set power off time
              pofftm_m = (entity[d_wday][i].stime + entity[d_wday][i].duration) % 60;
              sprintf(ts,"%02d:%02d %s",pofftm_h,pofftm_m,"poff scheduled");
              Serial.println(ts);
            }
            if (p_on==false && (inet_radio == 0 && !mode_chg_req)) {  // dsp_radio
              p_onoff_req = true;  //  if power off currently then power on req
              pofftm_h = 0;        // reset
              pofftm_m = 0;
              Serial.println("pw on req");
            } 
          } 
        }
      }
    }
  }
}

// display
void oled_display(int dmode){
  char ts[80];
  char buf[64];
  char buf1[64];
  char slp[8];
  oled.clearDisplay();
  oled.setTextSize(2); // Draw 2X-scale text
  if (dmode==0) { // time
    // display current time
    time_t t = time(NULL);
    tm = localtime(&t);
    d_mon  = tm->tm_mon+1;
    d_mday = tm->tm_mday;
    d_hour = tm->tm_hour;
    d_min  = tm->tm_min;
    d_sec  = tm->tm_sec;
    d_wday = tm->tm_wday;
    //Serial.print("time ");
    if (last_d_sec != d_sec) { // inet info
      sprintf(ts,"%02d:%02d:%02d",d_hour,d_min,d_sec);
      oled.setTextSize(2); // Draw 2X-scale text
      oled.setCursor(0, 0);
      oled.print(ts);
      //Serial.println(ts);
      sprintf(ts, "%02d-%02d %s", d_mon, d_mday, weekStr[d_wday]);
      oled.setCursor(0, 15);
      oled.print(ts);
      //Serial.println(ts);
      last_d_sec = d_sec; // 
    }
  } else {
    if (sleepmode) {
      sprintf(buf1,"SLP%02d V:%02d", s_remin, volume);
    } else if (!p_on) {
      sprintf(buf1,"OFF Vol:%02d", volume);
    } else {
      sprintf(buf1,"NET Vol:%02d", volume);
    }
    sprintf(buf,"%.10s",stnname);
    oled.setCursor(0, 0);
    oled.print(buf);
    oled.setCursor(0, 15);
    oled.print(buf1);
  }
  oled.setCursor(0, 35);
  oled.setTextSize(1); // Draw 1X-scale text
  oled.print(titlebuf); // title info
  oled.display();
  if (sleepmode) {
    check_sleep();
  }
}
// Check if sleep
void check_sleep()
{
  if (last_d_min != d_min) {
    last_d_min = d_min;
    s_remin --;
    if (s_remin==0) {  // fall asleep
      server.stop();
      // disconnect WiFi to sleep 
      WiFi.disconnect(true);
      oled.setTextSize(2); // Draw 2X-scale text
      oled.clearDisplay();
      oled.setCursor(0, 0);
      oled.print("Sleep!!");
      oled.display();
      Serial.println("Sleep");
      s = 1;
      delay(30000);
      //
      if (s==0) ESP.restart(); //if cancelled within 30 sec then restart
      oled.clearDisplay();  // put off
      oled.display(); 
      digitalWrite(LED_BUILTIN, HIGH); // put off
      esp_deep_sleep_start();  // sleep forever
    }
  }
}
// change volume
void updatevolume(uint8_t a, uint8_t b)
{
  if (b==0) { // push vol up
    if (inet_radio==1) {
      volume ++;
      if (volume > MAXVOL) volume = MAXVOL;// inet
    }    
    else if (inet_radio==0) {
      vol_r ++;
      if (vol_r > MAXVOL_R) vol_r = MAXVOL_R; // dsp
    }
  } else if (a==0) { // push vol down
    if (inet_radio==1) {
      volume --;     
      if (volume < 0) volume = 0;
    }
    else if (inet_radio==0) {
      vol_r --;
      if (vol_r < 0) vol_r = 0;
    } 
  }
  Serial.print("vl:"); 
  if (inet_radio==1) {
    Serial.println(volume);
    audio.setVolume(volume);
    preferences.putInt("vol",volume);
  } else if (inet_radio==0) {
    Serial.println(vol_r);
    radio.setVolume(vol_r);
    preferences.putInt("volr",vol_r);
  }
}
// volume int routine
void volup_setting(){
  ct2=millis();
  if ((ct2-pt2)>250) {
    //updatevolume(1, 0);
    b_srv = 0;  // (ver:0.55)
  }
  pt2=ct2;
}
void voldown_setting(){
  ct2=millis();
  if ((ct2-pt2)>250) {
    //updatevolume(0, 1);
    a_srv = 0;  // (ver:0.55)
  }
  pt2=ct2; 
}
// optional
void audio_info(const char *info){
    Serial.print("info        "); Serial.println(info);
}
void audio_id3data(const char *info){  //id3 metadata
    Serial.print("id3data     ");Serial.println(info);
}
void audio_eof_mp3(const char *info){  //end of file
    Serial.print("eof_mp3     ");Serial.println(info);
}
void audio_showstation(const char *info){
    Serial.print("station     ");Serial.println(info);
}
void audio_showstreaminfo(const char *info){
    Serial.print("streaminfo  ");Serial.println(info);
}
void audio_showstreamtitle(const char *info){
    sprintf(titlebuf,"%.128s",info);  // server data
    oled_display(1); // display inet info
}
void audio_bitrate(const char *info){
    Serial.print("bitrate     ");Serial.println(info);
}
void audio_commercial(const char *info){  //duration in sec
    Serial.print("commercial  ");Serial.println(info);
}
void audio_icyurl(const char *info){  //homepage
    Serial.print("icyurl      ");Serial.println(info);
}
void audio_lasthost(const char *info){  //stream URL played
    Serial.print("lasthost    ");Serial.println(info);
}
void audio_eof_speech(const char *info){
    Serial.print("eof_speech  ");Serial.println(info);
}
void power_onoff_setting() {
  if (p_onoff_req==false) {  // wait last req
     p_onoff_req = true;  // req
  }
}
// sleep int routine
void sleep_setting(){
  ct2=millis();
  if ((ct2-pt2)>250) {
    s = 0;  // toggle sleep on/off
  }
  pt2=ct2;
}
void station_setting1() { //DSP Radio
  if (stn_ok) {  // wait last req
    stnIdx++;
    stn_ok = false;
    if (stnIdx > MAXSTNIDX) stnIdx = 0;  // turn around to support single button
    //Serial.print("stnIdx+:");
    //Serial.println(stnIdx);
    //preferences.putInt("stix", stnIdx); ver 0.58
  }
}
// station change int routine
void station_setting(){
  ct2=millis();
  //delay(10);  // no effect here
  if ((ct2-pt2)>250) {
    //Serial.print("st:"); ver 0.58
    if (inet_radio==1) {
      station = station + 1;  // inet
      if (station>=max_station) station=0;
      //Serial.println(station);
      event=1; 
    }
    else if (inet_radio==0) station_setting1(); // dsp radio
  }
  pt2=ct2;
 } 
void station_setting_2() {
  if (stn_ok) {  // wait last req
    stnIdx--;
    stn_ok = false;
    if (stnIdx < 0) stnIdx = MAXSTNIDX; // turn around to support single button
    //Serial.print("stnIdx-:");
    //Serial.println(stnIdx);
    //preferences.putInt("stix", stnIdx);  ver 0.58
  }
}
