asmnoak/All_in_one_DSP_Radio-RDA5807_and_Internet_Radio-xiao_esp32s3/(commit log)

2025-09-24 Update xiao_esp32s3_ssd1306_i_d_b_radio_master.ino
    Prevent WDG Timer panic
    [xiao_esp32s3_ssd1306_i_d_b_radio_master.ino]
2025-09-24 Update README.md
    PCB Info
